eduquenoy/ThermostatConnecte/README.md

# ThermostatConnecte
 Thermostat connecté basé sur Arduino
