eduquenoy/ThermostatConnecte/documentation.md

# Thermostat Arduino

Pour être pratique, il doit pouvoir être piloté à distance.
Quelques exemples de projets de thermostat :

* <https://plaisirarduino.fr/thermostat-temperature-arduino/>
* <https://www.instructables.com/Arduino-Thermostat/>
* <https://projecthub.arduino.cc/frenchy22/precise-and-programmable-wireless-thermostat-bb4d38>
* <https://projecthub.arduino.cc/salhar1/mini-thermostat-f48c67>
* <https://forum.arduino.cc/t/thermoweb-un-projet-de-thermostat-connecte/415767>

Autres projets inspirants :

* <https://tutoduino.fr/tutoriels/regulation-de-chauffage-par-pid/>
* pour le wifi et serveur web :
  * <https://newbiely.fr/tutorials/arduino/arduino-web-server>
  * <https://docs.arduino.cc/retired/library-examples/wifi-library/WiFiWebServer/>
